nmatu0810/carryselect4-sky130/paper/main.tex

\documentclass[conference]{IEEEtran}
\usepackage{cite}
\usepackage{amsmath}
\usepackage{graphicx}
\usepackage{booktabs}
\usepackage{url}
\graphicspath{{../docs/figures/}}
\input{metrics.tex}
\newcommand{\um}{\,$\mu$m}
\newcommand{\umsq}{\,$\mu$m$^2$}

\begin{document}

\title{CarrySelect-4: A Registered 4-bit Carry-Select Adder from RTL to GDSII in SKY130 with a Logical-Effort Study of a Full-Custom Mirror Full Adder}

\author{\IEEEauthorblockN{Nguy Quoc Trung (23CE.B026) and Nguyen Minh Anh Tu (23CE085)}
\IEEEauthorblockA{Group 7, CE2032 VLSI Design, Faculty of Computer Engineering and Electronics\\
Vietnam--Korea University of Information and Communication Technology (VKU), Da Nang, Vietnam\\
trungnq.23ceb@vku.udn.vn, tunma.23ce@vku.udn.vn}}

\maketitle

\begin{abstract}
We built CarrySelect-4, a 4-bit carry-select adder (CSLA) behind a valid/ready interface, and took it
from RTL to GDSII on SkyWater SKY130 with open-source tools only. The adder has a 2-bit ripple block
and two speculative 2-bit blocks, and the low carry selects between their results. A three-state Moore
controller registers the inputs and outputs, which gives a latency of \metric{sim.latency_cycles}
cycles and one result every \metric{sim.cycles_per_result} cycles. Self-checking simulation passes
\metric{sim.exhaustive.checked} of \metric{sim.exhaustive.checked} input vectors. Synthesis with Yosys
gives \metric{synth.top.nand2_eq} NAND2 equivalents. After place and route with LibreLane at 100\,MHz,
setup and hold slack are positive in all nine signoff corners and DRC and LVS report no errors. In a
separate branch we sized, laid out and extracted a 28-transistor mirror full adder in Magic. A Logical
Effort estimate of its ripple-carry path, \metric{le.D_est_ps}\,ps, falls between the schematic SPICE
result (\metric{spice.D_pre_ps}\,ps) and the extracted one (\metric{spice.D_post_ps}\,ps).
\end{abstract}

\begin{IEEEkeywords}
carry-select adder, SKY130, OpenLane, LibreLane, logical effort, full-custom layout, mirror adder
\end{IEEEkeywords}

\section{Introduction}
In a ripple-carry adder (RCA) the carry passes through every bit, so the delay grows as $O(n)$ with the
word length $n$. A carry-select adder~\cite{bedrij1962} shortens this path. It computes the upper bits
twice, once for each possible incoming carry, and a multiplexer picks the right result once the real
carry is known. The price is extra area~\cite{weste2010}. We wanted to see what this trade looks like in
a real flow, so we built a 4-bit instance and followed it through RTL and verification, through
synthesis and static timing with Yosys~\cite{yosys} and OpenSTA~\cite{opensta}, and through place and
route with OpenLane~2 / LibreLane~\cite{openlane,librelane} on SKY130~\cite{skywater}. The second half
of the project goes down to transistor level. We drew the adder's leaf cell, a mirror full adder, in
Magic~\cite{magic} and checked how close a hand estimate with Logical Effort~\cite{sutherland1999}
comes to SPICE before and after layout.

\section{Architecture}
Fig.~\ref{fig:block} shows the top level. A 9-bit input word $\{c_{in}, b, a\}$ is captured in an input
bank of 9 flip-flops when \texttt{ld\_en = valid\_in \& ready\_out}. The CSLA splits its six full adders
into three 2-bit RCAs. The \emph{low} block adds $a[1{:}0]+b[1{:}0]+c_{in}$. The \emph{hi0} and
\emph{hi1} blocks both add $a[3{:}2]+b[3{:}2]$, one with a carry-in of 0 and one with 1. The carry
$c_2$ out of the low block drives the select inputs of three 2:1 multiplexers, which produce
\texttt{sum[3:2]} and \texttt{cout}. The full adder and multiplexer modules keep their hierarchy
through synthesis, because otherwise ABC is free to rebuild the netlist as a different adder. The
5-bit result goes into an output bank of 5 flip-flops. A Moore controller with two state bits
(Fig.~\ref{fig:fsm}) steps through IDLE, COMPUTE and DONE, and the unused state code falls back to IDLE.
All \metric{synth.top.ff_count} flip-flops use an asynchronous active-low reset.

\begin{figure}[t]
\centering

\caption{Registered CarrySelect-4 datapath and controller.}
\label{fig:block}
\end{figure}

\begin{figure}[t]
\centering

\caption{Moore controller: state codes, outputs and transitions.}
\label{fig:fsm}
\end{figure}

\section{Verification}
The testbench is self-checking SystemVerilog running on Verilator. A scoreboard compares each result
with vectors from an independent Python golden model and also checks that the latency is exactly two
cycles. Table~\ref{tab:ver} lists the cases. In Fig.~\ref{fig:wave} an input accepted at clock edge $k$
gives \texttt{valid\_out} at edge $k+2$, and the next result arrives two cycles after that.

\begin{table}[t]
\centering
\caption{Verification cases (Verilator, self-checking)}
\label{tab:ver}
\begin{tabular}{@{}llc@{}}
\toprule
Case & Scenario & Result \\
\midrule
1 & directed vectors after reset & \metric{sim.case1.status} \\
2 & back-to-back, latency and throughput & \metric{sim.case2.status} \\
3 & random \texttt{valid\_in} bubbles (30\%) & \metric{sim.case3.status} \\
4 & async reset in COMPUTE and in DONE & \metric{sim.case4.status} \\
5 & exhaustive, \metric{sim.exhaustive.checked} vectors, \metric{sim.exhaustive.errors} errors & \metric{sim.case5.status} \\
-- & illegal state \texttt{2'b11} & \metric{sim.case_illegal.status} \\
\bottomrule
\end{tabular}
\end{table}

\begin{figure}[t]
\centering

\caption{Case 2 waveform: latency of two cycles, one result every two cycles.}
\label{fig:wave}
\end{figure}

\section{Synthesis and Physical Design}
Yosys maps the design onto \texttt{sky130\_fd\_sc\_hd} cells. The result is \metric{synth.top.cell_count}
cells and \metric{synth.top.area_um2}\umsq, or \metric{synth.top.nand2_eq} NAND2 equivalents against a
budget of 500. We constrained a 10\,ns clock with 2\,ns input and output delays. OpenSTA then reports a
worst setup slack of \metric{sta.synth.wns_setup_ns}\,ns at the typical corner. The register-to-register
critical path, \texttt{\metric{sta.synth.crit_path}}, arrives after \metric{sta.synth.crit_arrival_ns}\,ns.

Fig.~\ref{fig:ad} compares the CSLA with a 4-bit RCA. With the hierarchy kept, the CSLA is clearly faster
(\metric{cmp.csla4.delay_ns} vs.\ \metric{cmp.rca4.delay_ns}\,ns) and larger
(\metric{cmp.csla4.area_um2} vs.\ \metric{cmp.rca4.area_um2}\umsq), so its area--delay product is
worse. The CSLA is about 27\% faster but about 1.75 times larger. We attribute the extra area to the
duplicated upper block (hi0 and hi1), which adds a second 2-bit adder; we did not test this
explanation separately. When ABC may flatten the logic, both adders shrink and slow down. The flat
CSLA is still the faster one (\metric{cmp.csla4_flat.delay_ns} vs.\ \metric{cmp.rca4_flat.delay_ns}\,ns)
and has the best area--delay product. This flat ranking depends on the tool version: an earlier run
with Yosys 0.70 in another environment ordered the two flat netlists the other way round, so we base
our conclusion on the hierarchical comparison only.

\begin{figure}[t]
\centering

\caption{CSLA-4 vs.\ RCA-4 after synthesis (typical corner); hatched bars are flattened netlists.}
\label{fig:ad}
\end{figure}

LibreLane places and routes the design with a 55\% core-utilization target and an aspect ratio of 1
(Fig.~\ref{fig:layout}); Table~\ref{tab:ppa} gives the signoff numbers. Setup and hold slack are
positive in all nine corners (min/nom/max extraction $\times$ ss/tt/ff), including the
recovery and removal checks on \texttt{rst\_n}. At the typical corner the estimated maximum frequency
is \metric{pnr.fmax_mhz}\,MHz. We computed it as $f_{max}\approx 1000/(T-s)$ MHz with $T=10$\,ns and $s$ the
worst setup slack at that corner; $s$ includes the input and output paths, whose 2\,ns delays are fixed,
so this is an estimate and not a signoff figure. \metric{pnr5.text_en}

\begin{table}[t]
\centering
\caption{Post-route signoff at 100\,MHz}
\label{tab:ppa}
\begin{tabular}{@{}lr@{}}
\toprule
Metric & Value \\
\midrule
Die area (\textmu m$^2$) & \metric{pnr.die_area_um2} \\
Std cells / final utilization (\%) & \metric{pnr.cell_count} / \metric{pnr.core_util_pct} \\
Setup slack, tt / worst corner (ns) & \metric{pnr.wns_setup_ns} / \metric{pnr.wns_setup_worst_corner_ns} \\
Hold slack, tt / worst corner (ns) & \metric{pnr.wns_hold_ns} / \metric{pnr.wns_hold_worst_corner_ns} \\
$f_{max}$ estimate, tt (MHz) & \metric{pnr.fmax_mhz} \\
DRC Magic / KLayout, LVS errors & \metric{pnr.drc_magic} / \metric{pnr.drc_klayout} / \metric{pnr.lvs_errors} \\
Antenna violations & \metric{pnr.antenna_violations} \\
Total power (mW), wirelength (\textmu m) & \metric{pnr.power_total_mw}, \metric{pnr.wirelength_um} \\
\bottomrule
\end{tabular}
\end{table}

\begin{figure}[t]
\centering

\caption{Routed layout of \texttt{carryselect4\_top} (LibreLane, SKY130).}
\label{fig:layout}
\end{figure}

\section{Full-Custom Full Adder and Logical Effort}
The leaf cell is a 28-transistor mirror adder. A majority (carry) gate produces $\overline{C_o}$, the
sum gate reuses that signal to produce $\overline{S}$, and two inverters restore the polarity. We
simulated an FO4 inverter in ngspice at the typical corner and obtained $\tau=\metric{le.tau_ps}$\,ps
(FO4 $=\metric{le.fo4_ps}$\,ps) and $p_{inv}=\metric{le.pinv}$ for $W_p/W_n$ =
\metric{le.wp_unit_um}/\metric{le.wn_unit_um}.

We analysed the 2-bit ripple path inside an RCA block. It runs from $a_0$ through two carry gates and
two inverters to $c_2$, which drives three multiplexer select pins ($C_{load}=3\,C_{S,\text{mux2}}$).
We took $g_{carry}=2$ and $g_{inv}=1$, and read the branching effort from the transistor widths. Then
\begin{equation}
F = GBH,\qquad \hat f = F^{1/N},\qquad D = N\hat f + P,
\end{equation}
with $G=\metric{le.G}$, $B=\metric{le.B}$, $H=\metric{le.H}$ and $N=\metric{le.N}$, so that
$F=\metric{le.F}$ and $\hat f=\metric{le.fhat}$. The parasitic term is $P = 2p_{carry}+2p_{inv}$, and
we simulated $p_{carry}=\metric{le.p_carry}$. This gives $D=\metric{le.D_est_tau}\,\tau=\metric{le.D_est_ps}$\,ps.
We tried two sizings. S1 scales each transistor by its stack depth. S2 also gives the carry-out
inverter the size that Logical Effort assigns to the last stage. S2 was faster in SPICE
(\metric{fa.s2.delay_pre_ps} vs.\ \metric{fa.s1.delay_pre_ps}\,ps), so we laid it out.

In the layout (Fig.~\ref{fig:fa}) the shared polysilicon columns follow Euler paths, which leaves a
single diffusion break in the pMOS and nMOS rows. Full-width n- and p-tap rows under the supply
rails keep every device within a few micrometres of a tap, well inside the 15\um\ latch-up limit. The
cell measures \metric{fa.width_um}\,$\times$\,\metric{fa.height_um}\um\ (\metric{fa.area_um2}\umsq).
That is about ten times the 20.02\umsq\ of the library's \texttt{fa\_1} cell. It is DRC-clean with the
full SKY130 deck and matches the schematic in Netgen LVS. Table~\ref{tab:le} and Fig.~\ref{fig:le}
compare the estimate with SPICE. Against the schematic simulation the estimate is off by
\metric{le.err_pre_pct}\% (too slow). Against the extracted netlist it is off by
\metric{le.err_post_pct}\% (too fast). The schematic netlist has no source/drain junction
capacitance, while extraction adds it together with \metric{fa.pex_cap_count} wiring capacitors.
Logical Effort folds all of this into one parasitic term per stage.

\begin{table}[t]
\centering
\caption{Ripple-carry path delay $a_0\rightarrow c_2$}
\label{tab:le}
\begin{tabular}{@{}lrr@{}}
\toprule
Method & Delay (ps) & LE error \\
\midrule
Logical Effort & \metric{le.D_est_ps} & -- \\
SPICE, schematic & \metric{spice.D_pre_ps} & \metric{le.err_pre_pct}\% \\
SPICE, extracted & \metric{spice.D_post_ps} & \metric{le.err_post_pct}\% \\
\bottomrule
\end{tabular}
\end{table}

\begin{figure}[t]
\centering

\caption{Full-custom 28T mirror full adder in Magic (DRC and LVS clean).}
\label{fig:fa}
\end{figure}

\begin{figure}[t]
\centering

\caption{Logical Effort estimate vs.\ SPICE before and after extraction.}
\label{fig:le}
\end{figure}

\section{Conclusion}
CarrySelect-4 reached its functional and timing targets. Exhaustive simulation passes, the routed
design closes at 100\,MHz in every corner with clean DRC, LVS and antenna checks, and it uses less than
half of its area budget. At four bits, with the hierarchy kept, the carry-select structure is faster
than ripple carry but has a worse area--delay product. The flattened netlists rank differently, but that
ranking depends on the tool version, so we do not draw conclusions from it. In the full-custom study, Logical Effort
picked the faster of the two sizings and gave a delay inside the pre- and post-layout band. It cannot
give an accurate absolute delay without a layout-aware parasitic term. The custom cell is a study
cell and is not used in the standard-cell flow.

Three limitations apply. The custom adder is much larger than the library cell: we did not optimise
its area, and its routing uses nine horizontal metal-1 tracks. The pre-layout simulation had no diffusion capacitance
(no \texttt{ad}, \texttt{as}, \texttt{pd}, \texttt{ps} on the devices), so the gap between the
pre- and post-layout results is likely larger than the layout alone would cause. And the ranking of
the flattened adders depends on the synthesis tool version. As next steps we would place the custom
adder in the flow as a macro with LEF and LIB views generated from its layout, and compare wider
adders (8 to 32 bits, with unequal block sizes), where carry-select should pay off more clearly.

\bibliographystyle{IEEEtran}
\bibliography{refs}

\end{document}
