nmatu0810/carryselect4-sky130/paper/metrics.tex

% generated by scripts/metrics_to_tex.py from results/metrics.json -- do not edit
\newcommand{\metric}[1]{\ifcsname metric@#1\endcsname\csname metric@#1\endcsname\else\errmessage{missing metric #1}\fi}

\expandafter\def\csname metric@cmp.csla4.adp\endcsname{294}
\expandafter\def\csname metric@cmp.csla4.area_um2\endcsname{236}
\expandafter\def\csname metric@cmp.csla4.cell_count\endcsname{15}
\expandafter\def\csname metric@cmp.csla4.delay_ns\endcsname{1.24}
\expandafter\def\csname metric@cmp.csla4.nand2_eq\endcsname{63}
\expandafter\def\csname metric@cmp.csla4_flat.adp\endcsname{180}
\expandafter\def\csname metric@cmp.csla4_flat.area_um2\endcsname{113}
\expandafter\def\csname metric@cmp.csla4_flat.cell_count\endcsname{18}
\expandafter\def\csname metric@cmp.csla4_flat.delay_ns\endcsname{1.59}
\expandafter\def\csname metric@cmp.csla4_flat.nand2_eq\endcsname{30}
\expandafter\def\csname metric@cmp.rca4.adp\endcsname{231}
\expandafter\def\csname metric@cmp.rca4.area_um2\endcsname{135}
\expandafter\def\csname metric@cmp.rca4.cell_count\endcsname{8}
\expandafter\def\csname metric@cmp.rca4.delay_ns\endcsname{1.71}
\expandafter\def\csname metric@cmp.rca4.nand2_eq\endcsname{36}
\expandafter\def\csname metric@cmp.rca4_flat.adp\endcsname{218}
\expandafter\def\csname metric@cmp.rca4_flat.area_um2\endcsname{109}
\expandafter\def\csname metric@cmp.rca4_flat.cell_count\endcsname{14}
\expandafter\def\csname metric@cmp.rca4_flat.delay_ns\endcsname{2.00}
\expandafter\def\csname metric@cmp.rca4_flat.nand2_eq\endcsname{29}
\expandafter\def\csname metric@env.magic_version\endcsname{8.3.685}
\expandafter\def\csname metric@env.ngspice_version\endcsname{ngspice-47 : Circuit level simulation program}
\expandafter\def\csname metric@env.openlane_version\endcsname{LibreLane v3.0.16}
\expandafter\def\csname metric@env.pdk_hash\endcsname{8afc8346a57fe1ab7934ba5a6056ea8b43078e71}
\expandafter\def\csname metric@env.verilator_version\endcsname{Verilator 5.052 2026-09-05 rev v5.052}
\expandafter\def\csname metric@env.yosys_version\endcsname{Yosys 0.66 (git sha1 86f2ddebc-dirty, g++ 16.1.1 -march=x86-64 -mtune=generic -O2 -fno-plt -fexceptions -fstack-clash-protection -fcf-protection -fno-omit-frame-pointer -mno-omit-leaf-frame-pointer -ffile-prefix-map=/build/yosys/src=/usr/src/debug/yosys -fPIC -O3) [startdir/yosys at makepkg]}
\expandafter\def\csname metric@fa.area_um2\endcsname{200}
\expandafter\def\csname metric@fa.drc_errors\endcsname{0}
\expandafter\def\csname metric@fa.height_um\endcsname{12.3}
\expandafter\def\csname metric@fa.lvs_match\endcsname{true}
\expandafter\def\csname metric@fa.ntrans\endcsname{28}
\expandafter\def\csname metric@fa.pex_cap_count\endcsname{80}
\expandafter\def\csname metric@fa.s1.delay_pre_ps\endcsname{307}
\expandafter\def\csname metric@fa.s2.delay_pre_ps\endcsname{264}
\expandafter\def\csname metric@fa.sizing_chosen\endcsname{S2}
\expandafter\def\csname metric@fa.taps\endcsname{2}
\expandafter\def\csname metric@fa.width_um\endcsname{16.2}
\expandafter\def\csname metric@le.B\endcsname{31.5}
\expandafter\def\csname metric@le.D_est_ps\endcsname{312}
\expandafter\def\csname metric@le.D_est_tau\endcsname{24.2}
\expandafter\def\csname metric@le.F\endcsname{183}
\expandafter\def\csname metric@le.G\endcsname{4}
\expandafter\def\csname metric@le.H\endcsname{1.45}
\expandafter\def\csname metric@le.N\endcsname{4}
\expandafter\def\csname metric@le.c_mux_s_ff\endcsname{3.40}
\expandafter\def\csname metric@le.err_post_pct\endcsname{-25.7}
\expandafter\def\csname metric@le.err_pre_pct\endcsname{18.2}
\expandafter\def\csname metric@le.fhat\endcsname{3.68}
\expandafter\def\csname metric@le.fo4_ps\endcsname{64.5}
\expandafter\def\csname metric@le.p_carry\endcsname{3.60}
\expandafter\def\csname metric@le.pinv\endcsname{1.13}
\expandafter\def\csname metric@le.tau_ps\endcsname{12.9}
\expandafter\def\csname metric@le.wn_unit_um\endcsname{0.420}
\expandafter\def\csname metric@le.wp_unit_um\endcsname{0.840}
\expandafter\def\csname metric@pnr.antenna_violations\endcsname{0}
\expandafter\def\csname metric@pnr.cell_count\endcsname{123}
\expandafter\def\csname metric@pnr.core_util_pct\endcsname{80.7}
\expandafter\def\csname metric@pnr.die_area_um2\endcsname{3340}
\expandafter\def\csname metric@pnr.drc_klayout\endcsname{0}
\expandafter\def\csname metric@pnr.drc_magic\endcsname{0}
\expandafter\def\csname metric@pnr.fmax_mhz\endcsname{280}
\expandafter\def\csname metric@pnr.lvs_errors\endcsname{0}
\expandafter\def\csname metric@pnr.power_total_mw\endcsname{0.363}
\expandafter\def\csname metric@pnr.wirelength_um\endcsname{1587}
\expandafter\def\csname metric@pnr.wns_hold_ns\endcsname{0.384}
\expandafter\def\csname metric@pnr.wns_hold_worst_corner_ns\endcsname{0.151}
\expandafter\def\csname metric@pnr.wns_setup_ns\endcsname{6.42}
\expandafter\def\csname metric@pnr.wns_setup_worst_corner_ns\endcsname{5.21}
\expandafter\def\csname metric@pnr5.grade_vi\endcsname{Đạt}
\expandafter\def\csname metric@pnr5.limit_vi\endcsname{Chạy mở rộng 5 ns đạt timing ở cả 9 corner; chưa thử chu kỳ ngắn hơn 5 ns.}
\expandafter\def\csname metric@pnr5.slide_value\endcsname{đạt 9/9 corner}
\expandafter\def\csname metric@pnr5.status\endcsname{PASS}
\expandafter\def\csname metric@pnr5.summary_vi\endcsname{đạt timing ở cả 9 corner (setup xấu nhất 0.211 ns)}
\expandafter\def\csname metric@pnr5.text_en\endcsname{A second run at a 5 ns clock meets setup and hold in all 9 corners; the worst setup slack is 0.211 ns.}
\expandafter\def\csname metric@pnr5.text_vi\endcsname{Lệnh `make pnr5` chạy cùng cấu hình với chu kỳ 5 ns (SDC sinh lại vào `syn/out/constraints\_5ns.sdc`). Kết quả: **PASS**, đạt timing ở cả 9 corner. Setup slack xấu nhất là 0.211 ns, hold slack xấu nhất là 0.151 ns, DRC và LVS vẫn sạch. Thiết kế chạy được 200 MHz ở mọi corner.}
\expandafter\def\csname metric@pnr5.wns_hold_ns\endcsname{0.384}
\expandafter\def\csname metric@pnr5.wns_hold_worst_corner_ns\endcsname{0.151}
\expandafter\def\csname metric@pnr5.wns_setup_ns\endcsname{1.42}
\expandafter\def\csname metric@pnr5.wns_setup_worst_corner_ns\endcsname{0.211}
\expandafter\def\csname metric@sim.case1.status\endcsname{PASS}
\expandafter\def\csname metric@sim.case2.status\endcsname{PASS}
\expandafter\def\csname metric@sim.case3.status\endcsname{PASS}
\expandafter\def\csname metric@sim.case4.status\endcsname{PASS}
\expandafter\def\csname metric@sim.case5.status\endcsname{PASS}
\expandafter\def\csname metric@sim.case_illegal.status\endcsname{PASS}
\expandafter\def\csname metric@sim.cycles_per_result\endcsname{2}
\expandafter\def\csname metric@sim.exhaustive.checked\endcsname{512}
\expandafter\def\csname metric@sim.exhaustive.errors\endcsname{0}
\expandafter\def\csname metric@sim.latency_cycles\endcsname{2}
\expandafter\def\csname metric@sim.unit_csla4.checked\endcsname{512}
\expandafter\def\csname metric@sim.unit_csla4.errors\endcsname{0}
\expandafter\def\csname metric@spice.D_post_ps\endcsname{420}
\expandafter\def\csname metric@spice.D_pre_ps\endcsname{264}
\expandafter\def\csname metric@sta.synth.crit_arrival_ns\endcsname{1.78}
\expandafter\def\csname metric@sta.synth.crit_path\endcsname{a\_q[0] -> cout\_q}
\expandafter\def\csname metric@sta.synth.wns_hold_ns\endcsname{0.243}
\expandafter\def\csname metric@sta.synth.wns_setup_ns\endcsname{6.78}
\expandafter\def\csname metric@sta.synth.worst_path\endcsname{valid\_in -> a\_q[0]}
\expandafter\def\csname metric@synth.nand2_area_um2\endcsname{3.75}
\expandafter\def\csname metric@synth.top.area_um2\endcsname{817}
\expandafter\def\csname metric@synth.top.cell_count\endcsname{49}
\expandafter\def\csname metric@synth.top.ff_count\endcsname{16}
\expandafter\def\csname metric@synth.top.latch_count\endcsname{0}
\expandafter\def\csname metric@synth.top.nand2_eq\endcsname{218}
