nmatu0810/carryselect4-sky130/docs/figures/layout_top_zoom.png

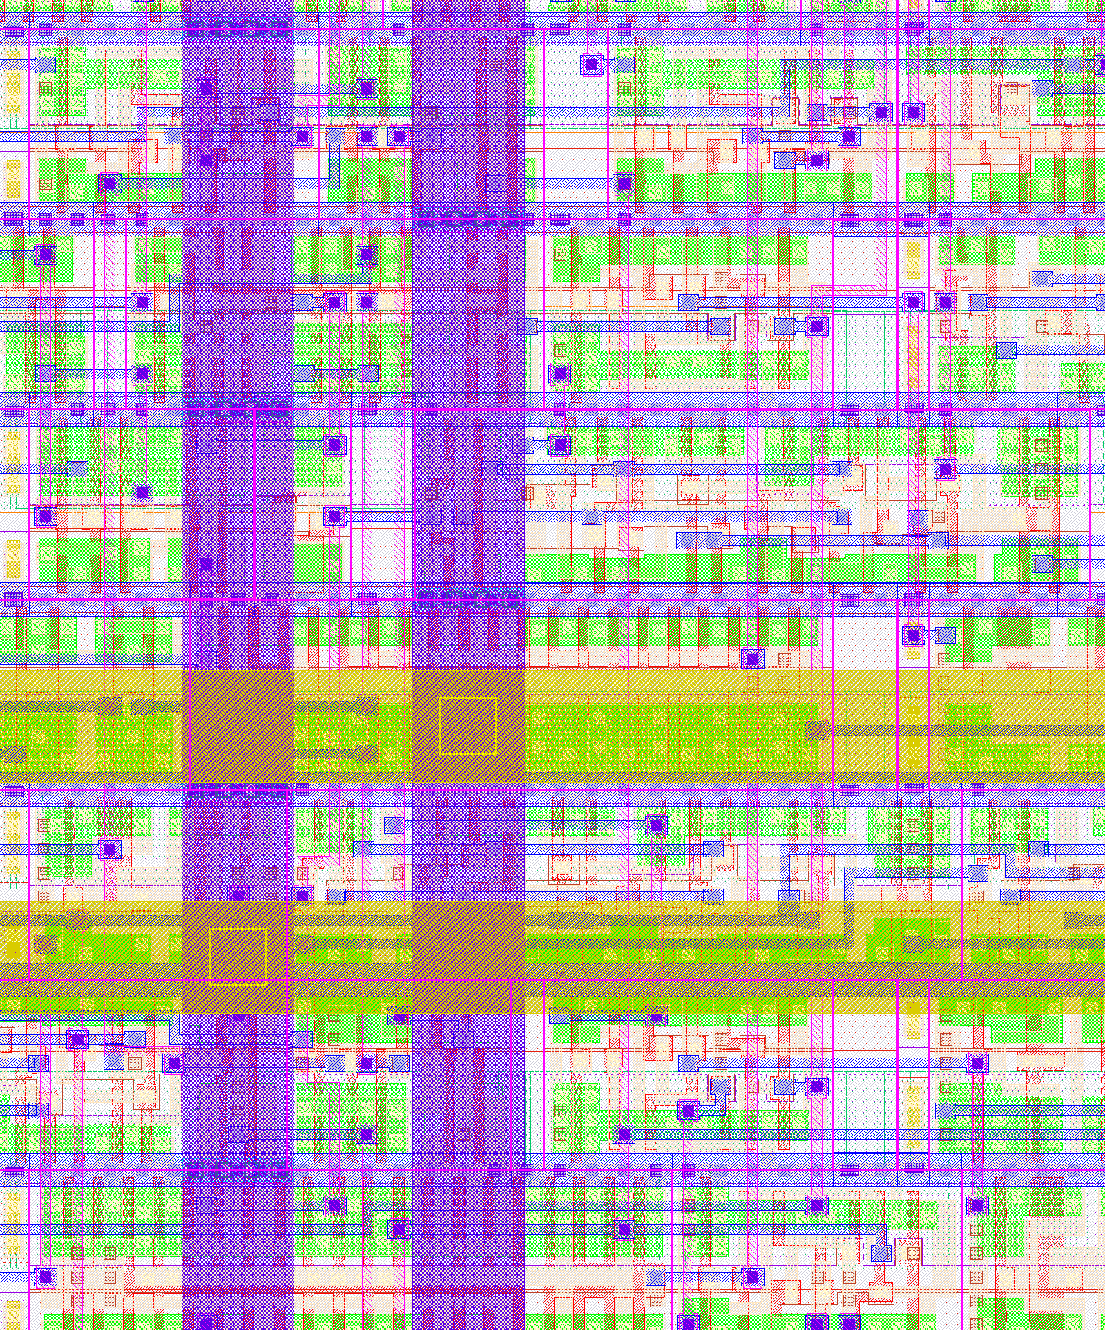
docs/figures/layout_top_zoom.png
