nmatu0810/carryselect4-sky130/results/cmp.csv

variant | area_um2 | nand2_eq | cell_count | delay_ns | adp
csla4 | 236.477 | 63.0 | 15 | 1.242 | 293.704
rca4 | 135.13 | 36.0 | 8 | 1.71 | 231.072
csla4_flat | 112.608 | 30.0 | 18 | 1.595 | 179.61
rca4_flat | 108.854 | 29.0 | 14 | 2.005 | 218.252
