nmatu0810/carryselect4-sky130/(commit log)

2026-11-01 test(verif): throughput, handshake, async reset and illegal-state cases
    [tb_top.sv]
2026-11-01 feat(syn): CSLA vs RCA area-delay comparison
    [cmp.csv]
2026-11-01 feat(pnr): OpenLane2 RTL-to-GDSII at 10ns
    LibreLane 3.0.16, hierarchy kept. All 9 corners meet setup/hold
    (worst setup 4.799 ns, worst hold 0.111 ns); Magic/KLayout DRC and LVS
    report 0 errors. 5 ns extension fails only at ss corners (-0.045 ns).
    run_pnr.sh falls back to native tools when no Docker image is present
    (D4).
    [carryselect4_top__max_ff_n40C_1v95.sdf, carryselect4_top__max_ss_100C_1v60.sdf, carryselect4_top__max_tt_025C_1v80.sdf, carryselect4_top__min_ff_n40C_1v95.sdf, carryselect4_top__min_ss_100C_1v60.sdf, carryselect4_top__min_tt_025C_1v80.sdf, carryselect4_top__nom_ff_n40C_1v95.sdf, carryselect4_top__nom_ss_100C_1v60.sdf]
2026-11-01 feat(pnr): extract post-route metrics and layout renders
    pnr.* keys from LibreLane final metrics (mapping in parse_ol_metrics.py);
    fmax 277 MHz at nom tt. gds2png.py renders full die and 30% centre zoom.
2026-11-01 feat(le): logical-effort calculator and FO4 tau characterization
    le_calc.py (stdlib) with 4 unit tests. FO4 in sky130 tt: Wp=0.84 um
    balances rise/fall, fo4=64.5 ps, tau=12.9 ps, pinv=1.13;
    mux2_1 S pin = 3.40 fF.
2026-11-01 feat(custom): 28T mirror full adder schematic, LE-driven sizing
    S1 sizes every branch by stack depth; S2 swaps in the LE-optimal CO
    inverter (1.58x unit). D-9 path: G=4, B=31.5, H=1.45, F=183,
    f_hat=3.68, LE estimate 312 ps. Pre-layout SPICE: S1 306.5 ps,
    S2 263.9 ps -> S2 selected. fa_func.sp 8/8 PASS.
2026-11-01 feat(custom): full-custom FA layout in magic, DRC clean, tapped
    gen_layout.py draws fa_cell from fa_cell.spice: shared p/n poly columns
    in Euler order (one diffusion break), li straps + 9 met1 tracks, full-
    width n-tap/p-tap rows under the rails. 16.24 x 12.33 um, 28 devices,
    drc(full) 0 errors, worst tap distance 2.96 um (LU.2/LU.3 < 15 um).
2026-11-01 feat(custom): FA LVS, PEX and post-layout LE vs SPICE comparison
    netgen: circuits match uniquely (28 devices, 19 nets, no property
    errors). PEX (ngspice format, 80 non-zero caps + layout ad/as/pd/ps).
    D-9 path: LE 312.0 ps, SPICE pre 263.9 ps, post 419.9 ps; LE error
    +18.2% vs pre, -25.7% vs post. The post-layout increase comes mostly
    from junction capacitance absent in the schematic netlist and ~4 fF of
    wiring on COb/CI.
    [le_compare.csv]
2026-11-01 docs(report): docx builder and chapters 1-3
    report/build_docx.mjs (docx-js): cover from 00_meta.json, TOC field,
    numbered headings, lists, captioned tables and 15 cm figures, inline
    bold/italic/code, {{metric}} placeholders that fail the build when the
    key is missing (verified with a self-test, then removed). A4, TNR 13 pt,
    1.3 spacing, margins 2/2/3/2 cm, page numbers. Chapters 1-3 in
    Vietnamese.
2026-11-01 docs(report): chapters 4-6 verification, synthesis, physical design
    Chapter 4: testbench, golden model, case matrix, mutation evidence,
    case2/case4 waveforms. Chapter 5: Yosys, SDC, area, STA path excerpt,
    CSLA vs RCA area-delay. Chapter 6: LibreLane steps, sign-off table,
    5 ns run, deviations D1-D5. Builder supports escaped pipes in tables.
    Number format (paper and report): 3 significant figures, at most 3
    decimals, half-up rounding, identical in Python and JavaScript.
2026-11-01 docs(report): chapters 7-9, final docx
    Chapter 7: 28T mirror adder, tau characterization, step-by-step Logical
    Effort (G, B, H, F, f_hat, D), S1/S2 sizing, Euler-path layout, latch-up
    taps, DRC/LVS/PEX, LE vs SPICE with error analysis. Chapter 8: goals vs
    results, limitations, future work, work split marked [cần xác nhận].
    Chapter 9: IEEE references and appendices. 9 chapters, 10 figures,
    17 tables.
2026-11-03 fix(pnr): rerun PnR with the official Docker image, 5 ns status from metrics
    - run_pnr.sh: run librelane --dockerized under `script` when stdin is not a TTY and keep
    its exit code; stop overwriting results/logs/t8.txt; save the 5 ns metrics and a
    run_info.json (mode, image, hierarchy mode) next to each run.
    - parse_ol_metrics.py: --run 5ns writes pnr5.* (status PASS only if every corner >= 0 and
    DRC/LVS are 0); results/logs/t8.txt is generated from the run metrics.
    - pnr5_text.py: paper, report and slides take the 5 ns wording from pnr5.status.
    - make pnr / pnr5 rerun with ghcr.io/librelane/librelane:3.0.16 and PDK 8afc8346; layout
    images and figures regenerated; GDS sha256 updated;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
    [carryselect4_top__max_ff_n40C_1v95.sdf, carryselect4_top__max_ss_100C_1v60.sdf, carryselect4_top__max_tt_025C_1v80.sdf, carryselect4_top__min_ff_n40C_1v95.sdf, carryselect4_top__min_ss_100C_1v60.sdf, carryselect4_top__min_tt_025C_1v80.sdf, carryselect4_top__nom_ff_n40C_1v95.sdf, carryselect4_top__nom_ss_100C_1v60.sdf]
2026-11-03 docs(report): rework docx formatting
    - cover in its own section with a page border and no page number;
    table of contents numbered i, ii, ...; chapters start again at 1
    - chapter titles centred in capitals; body paragraphs justified with a
    1 cm first-line indent
    - tables: column widths follow the content and always fit the longest
    word, rows never split across pages, header row repeats, tables of
    up to 12 rows stay on one page, caption kept with its table
    - formulas: x_sub and x^(sup) inside italics become real subscripts and
    superscripts; a paragraph that is a single italic span is centred
    - figures limited to 15 x 11 cm
    Text content is unchanged (built from report/vi/*.md as befo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
2026-11-03 docs(report): faculty template layout, merge 9 chapters into 4
    Structure: Mở đầu, Chương 1 Cơ sở lý thuyết, Chương 2 Thiết kế và kiểm
    chứng chức năng (old 3+4), Chương 3 Tổng hợp và thiết kế vật lý (old
    5+6), Chương 4 Full Adder full-custom và Logical Effort, Kết luận và
    hướng phát triển, Danh mục tài liệu tham khảo, Phụ lục. Text unchanged
    except the chapter references it needs: report outline in Mở đầu,
    'chương 7/5' -> 'chương 4/3', 'chương 5' -> 'mục 3.1.2', and the stale
    'Bảng 2' (FSM table, now table 3 document-wide).
    Layout from the BaoCao_DACN2 template: framed cover with VKU logo and
    inner cover; superv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
2026-11-03 docs(slides): 12-slide deck following the report structure
    Mở đầu, chapters 1-4 and Kết luận as in the report; theory slide with
    formula cards (real subscripts/superscripts), merged architecture/CSLA,
    FSM/waveform, synthesis/comparison and FA layout/Euler slides; speaker
    notes per slide. verify_all accepts 10-18 slides.
